diaconuccalin/CanSat2016/Documente/New folder (3)/cansat 3.jpg

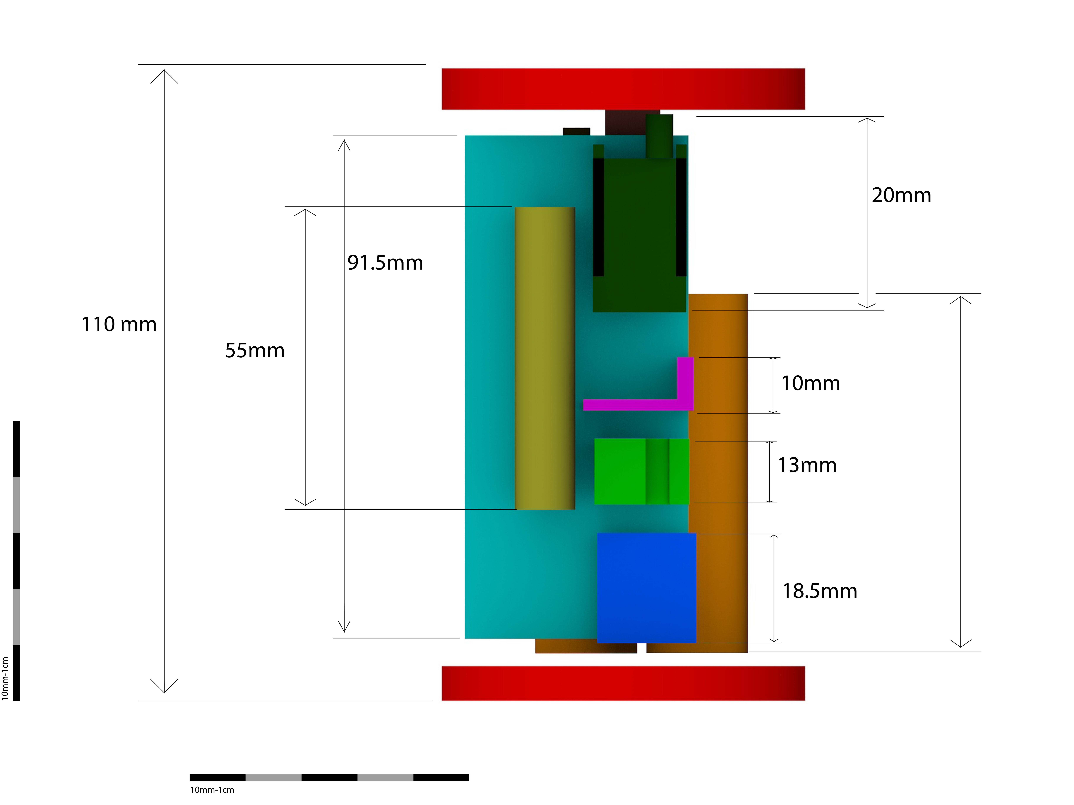
Documente/New folder (3)/cansat 3.jpg
