diaconuccalin/CanSat2016/Documente/qbcan_schematic.PNG

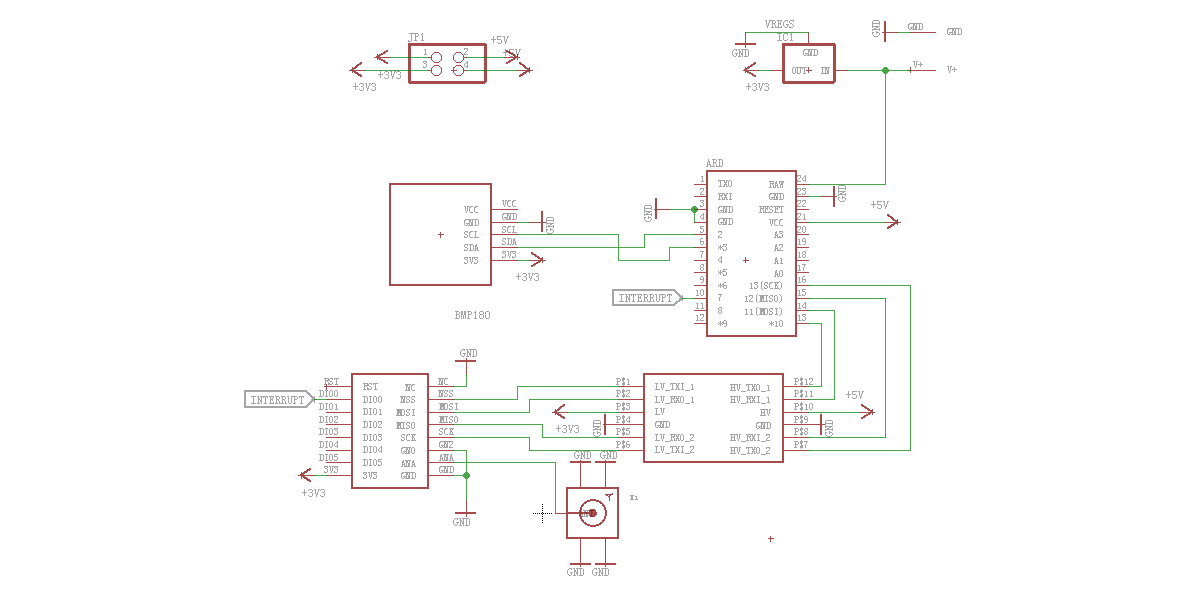
Documente/qbcan_schematic.PNG
