diaconuccalin/CanSat2016/Documente/schematic-dht11t.png

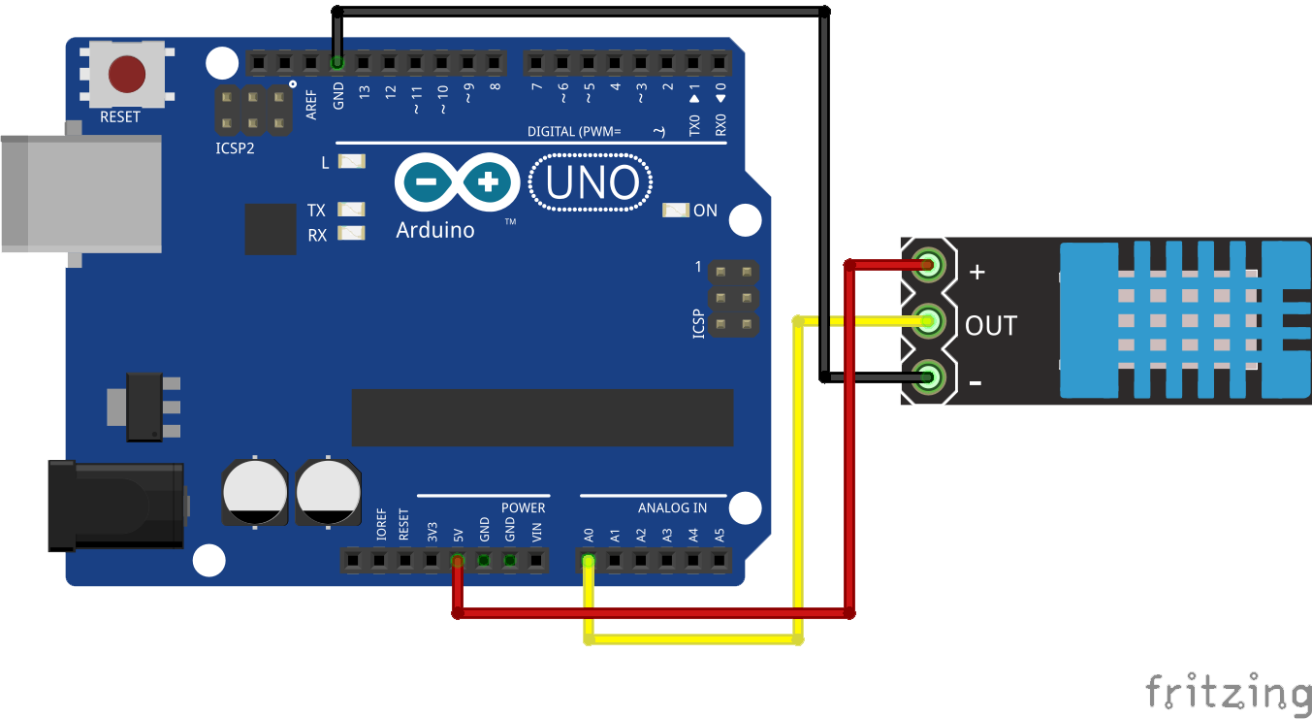
Documente/schematic-dht11t.png
