diaconuccalin/CanSat2016/(list of files, drawings)

Other design files:
Documente/fritzing/cansat.fzz
