diaconuccalin/CanSat2016/sketches/final_micro/final_micro.ino

//radio
#include <RFM69.h>

//sd
#include <SD.h>

//tempres
#include <qbcan.h>
#include <SPI.h>
#include <Wire.h>
BMP180 bmp;

<<<<<<< HEAD
=======
/*/accel
int SENSOR_SIGN[9] = {1,1,1,-1,-1,-1,1,1,1};
unsigned long previousMillisAcc = 0;

#include <L3G.h>
#include <LSM303.h>

L3G gyro;
LSM303 compass;

#define ToRad(x) ((x)*0.01745329252)
#define ToDeg(x) ((x)*57.2957795131)
#define Gyro_Scaled_X(x) ((x)*ToRad(0.07))
#define Gyro_Scaled_Y(x) ((x)*ToRad(0.07))
#define Gyro_Scaled_Z(x) ((x)*ToRad(0.07))

float G_Dt=0.02;
unsigned long timer=0, timer_old, timer24=0;
int AN[6], AN_OFFSET[6]={0,0,0,0,0,0};

int gyro_x, gyro_y, gyro_z, accel_x, accel_y, accel_z, magnetom_x, magnetom_y, magnetom_z;
float c_magnetom_x, c_magnetom_y, c_magnetom_z, MAG_Heading;
float Accel_Vector[3] = {0, 0, 0};
float Gyro_Vector[3] = {0, 0, 0};
float Omega_Vector[3] = {0, 0, 0};
float Omega_P[3] = {0, 0, 0};
float Omega_I[3] = {0, 0, 0};
float Omega[3] = {0, 0, 0};

float roll, pitch, yaw;
float errorRollPitch[3] = {0, 0, 0};
float errorYaw[3] = {0, 0, 0};

unsigned int counter=0;
byte gyro_sat=0;

float DCM_Matrix[3][3]= {
  {1,0,0},
  {0,1,0},
  {0,0,1}
}; 
float Update_Matrix[3][3]={{0,1,2},{3,4,5},{6,7,8}};

float Temporary_Matrix[3][3]={
  {
    0,0,0  }
  ,{
    0,0,0  }
  ,{
    0,0,0  }
};
*/
//temp+humid
unsigned long previousMillis = 0;
#include <dht.h>
#define dht_apin A0
dht DHT;

//GPS
#include <SoftwareSerial.h>
SoftwareSerial gpsSerial(9, 7); // RX, TX (TX not used)
char sentence[80];


>>>>>>> 387320f574f8ba8f5f3e8b936d95b204bb287ada
void setup()
{  
  //temp+pres
  bmp.begin();
<<<<<<< HEAD
=======
  
  /*/accelerometru
  Wire.begin();
  delay(1500);
  Accel_Init();
  Compass_Init();
  Gyro_Init();
  
  delay(20);

  for(int i=0; i<32; i++)
  {
    Read_Gyro();
    Read_Accel();
    for(int y=0; y<6; y++)
      AN_OFFSET[y]+=AN[y];
    delay(20);
  }

  for(int y=0; y<6; y++)
    AN_OFFSET[y] = AN_OFFSET[y]/32;

  AN_OFFSET[5]-=256*SENSOR_SIGN[5];

  delay(2000);

  timer=millis();
  delay(20);
  counter=0;
  */
  /*
  //speaker
  pinMode(6, OUTPUT);
  */
  //GPS
  Serial.begin(9600);
  gpsSerial.begin(9600);

  //SD
  while(!Serial)
  {;}

  Serial.println("Initializing SD card...");

  if(!SD.begin(8))
  {
    Serial.println("Card failed, or not present");
    return;
  }
  Serial.println("card initialized");
>>>>>>> 387320f574f8ba8f5f3e8b936d95b204bb287ada
}

void loop()
{
<<<<<<< HEAD
    //temp+pres
    double T, P;
    bmp.getData(T, P);

    Serial.print("Pressure: ");
    Serial.print(P, 2);
    Serial.println(" mb.");
    Serial.print("Temperature: ");
    Serial.print(T, 2);
    Serial.println(" deg C");
    //temp+pres   
=======
  //SD
  File dataFile = SD.open("data.txt", FILE_WRITE);
  if(dataFile)
  {
  //SD
  
  /*/----------------------------accelerometru----------------------------
  unsigned long currentMillisAcc = millis();
  //----------------------------accelerometru----------------------------
  */
  //temp+humid
  unsigned long currentMillis = millis();

  //------------------------------GPS------------------------------
  int a, flag=0;
  static int i = 0;
  if (gpsSerial.available())
  {
    char ch = gpsSerial.read();
    if (ch != '\n' && i < 80)
    {
      sentence[i] = ch;
      i++;
    }
    else
    {
     sentence[i] = '\0';
     i = 0;
     
     if(sentence[4]=='G')
     {
      dataFile.print("---------------GPS---------------\n");
      
      dataFile.print("GMT: ");
      dataFile.print(sentence[7]);
      dataFile.print(sentence[8]);
      dataFile.print(":");
      dataFile.print(sentence[9]);
      dataFile.print(sentence[10]);
      dataFile.print(":");
      dataFile.print(sentence[11]);
      dataFile.print(sentence[12]);
      dataFile.print("\n");
      
      dataFile.print("Lat: ");
      
      for(a=18; a<=26; a++)
        dataFile.print(sentence[a]);
      
      dataFile.print(" ");
      dataFile.print(sentence[28]);
      dataFile.print("\n");
      
      dataFile.print("Long: ");

      for(a=30; a<=39; a++)
        dataFile.print(sentence[a]);
      
      dataFile.print(" ");
      dataFile.print(sentence[41]);
      dataFile.print("\n");

      dataFile.print("Sat: ");
      dataFile.print(sentence[45]);
      dataFile.print(sentence[46]);
      dataFile.print("\n");

      dataFile.print("Alt: ");

      for(a=48; a<=60 && flag!=2; a++)
      {
        if(flag==0)
        {
          if(sentence[a]==',')
            flag=1;
        }
        else
        {
          if(flag==1)
          {
            if(sentence[a]==',')
              flag=2;
            else
              dataFile.print(sentence[a]);
          }
        }
      }
      dataFile.print(" m \n");
     }
    }
  }
  //------------------------------GPS------------------------------
  else
  {
    /*/acceleometru
    if((millis()-timer)>=20)
    {
      counter++;
      timer_old=timer;
      timer=millis();
      if(timer>timer_old)
        G_Dt = (timer-timer_old)/1000.0;
      else
        G_Dt = 0;

      Read_Gyro();
      Read_Accel();

      if(counter>5)
      {
        counter=0;
        Read_Compass();
        Compass_Heading();
      }

      Matrix_update();
      Normalize();
      Drift_correction();
      Euler_angles();
      if(currentMillisAcc-previousMillisAcc>=20)
      {
        previousMillisAcc=currentMillisAcc;
        dataFile.close();
        printdata();
        dataFile = SD.open("data.txt", FILE_WRITE);
      }
    }
    //accelerometru
    */
    //temp+humid
    if(currentMillis-previousMillis>=2000) //minim 2 secunde intre citiri
    {
      previousMillis=currentMillis;
      DHT.read11(dht_apin);
      
      dataFile.print("\nhum=");
      dataFile.print(DHT.humidity);
      dataFile.print("% temp=");
      dataFile.print(DHT.temperature);
      dataFile.print("C \n");
    }
    //temp+humid

    //temp+pres
    double T, P;
    bmp.getData(T,P);
    
    dataFile.print("Pressure: ");
    dataFile.print(P, 2);
    dataFile.println(" mb.");
    dataFile.print("Temperature: ");
    dataFile.print(T,2);
    dataFile.println(" deg C.");
    //temp+pres
 }

/*  //speaker
  digitalWrite(6, HIGH);
  delay(1);
  digitalWrite(6,LOW);
  //speaker
*/
  //SD
  dataFile.close();
  }
  else
  {
    Serial.println("error opening data.txt :(");
  }
  //SD
}



/*


//---------------------------------accelerometru---------------------------------
void Gyro_Init()
{
  gyro.init();
  gyro.enableDefault();
  gyro.writeReg(L3G::CTRL_REG4, 0x20);
  gyro.writeReg(L3G::CTRL_REG1, 0x0F);
}

void Read_Gyro()
{
  gyro.read();
  
  AN[0] = gyro.g.x;
  AN[1] = gyro.g.y;
  AN[2] = gyro.g.z;
  gyro_x = SENSOR_SIGN[0] * (AN[0] - AN_OFFSET[0]);
  gyro_y = SENSOR_SIGN[1] * (AN[1] - AN_OFFSET[1]);
  gyro_z = SENSOR_SIGN[2] * (AN[2] - AN_OFFSET[2]);
}

void Accel_Init()
{
  compass.init();
  compass.enableDefault();
  switch(compass.getDeviceType())
  {
    case LSM303::device_D:
      compass.writeReg(LSM303::CTRL2, 0x18);
      break;
    case LSM303::device_DLHC:
      compass.writeReg(LSM303::CTRL_REG4_A, 0x28);
      break;
    default:
      compass.writeReg(LSM303::CTRL_REG4_A, 0x30);
  }
}

void Read_Accel()
{
  compass.readAcc();

  AN[3] = compass.a.x >> 4;
  AN[4] = compass.a.y >> 4;
  AN[5] = compass.a.z >> 4;
  accel_x = SENSOR_SIGN[3] * (AN[3] - AN_OFFSET[3]);
  accel_y = SENSOR_SIGN[4] * (AN[4] - AN_OFFSET[4]);
  accel_z = SENSOR_SIGN[5] * (AN[5] - AN_OFFSET[5]);
}

void Compass_Init(){}

void Read_Compass()
{
  compass.readMag();

  magnetom_x = SENSOR_SIGN[6] * compass.m.x;
  magnetom_y = SENSOR_SIGN[7] * compass.m.y;
  magnetom_z = SENSOR_SIGN[8] * compass.m.z;
}

void Compass_Heading()
{
  float MAG_X;
  float MAG_Y;
  float cos_roll;
  float sin_roll;
  float cos_pitch;
  float sin_pitch;
  
  cos_roll = cos(roll);
  sin_roll = sin(roll);
  cos_pitch = cos(pitch);
  sin_pitch = sin(pitch);
  
  c_magnetom_x = (float)(magnetom_x - SENSOR_SIGN[6]*(-421)) / (424 - (-421)) - SENSOR_SIGN[6]*0.5;
  c_magnetom_y = (float)(magnetom_y - SENSOR_SIGN[7]*(-639)) / (295 - (-639)) - SENSOR_SIGN[7]*0.5;
  c_magnetom_z = (float)(magnetom_z - SENSOR_SIGN[8]*(-238)) / (472 - (-238)) - SENSOR_SIGN[8]*0.5;
  
  MAG_X = c_magnetom_x*cos_pitch+c_magnetom_y*sin_roll*sin_pitch+c_magnetom_z*cos_roll*sin_pitch;
  MAG_Y = c_magnetom_y*cos_roll-c_magnetom_z*sin_roll;
  MAG_Heading = atan2(-MAG_Y,MAG_X);
}

void Matrix_update(void)
{
  Gyro_Vector[0]=Gyro_Scaled_X(gyro_x);
  Gyro_Vector[1]=Gyro_Scaled_Y(gyro_y);
  Gyro_Vector[2]=Gyro_Scaled_Z(gyro_z);

  Accel_Vector[0]=accel_x;
  Accel_Vector[1]=accel_y;
  Accel_Vector[2]=accel_z;

  Vector_Add(&Omega[0], &Gyro_Vector[0], &Omega_I[0]);
  Vector_Add(&Omega_Vector[0], &Omega[0], &Omega_P[0]);
       
  Update_Matrix[0][0]=0;
  Update_Matrix[0][1]=-G_Dt*Omega_Vector[2];
  Update_Matrix[0][2]=G_Dt*Omega_Vector[1];
  Update_Matrix[1][0]=G_Dt*Omega_Vector[2];
  Update_Matrix[1][1]=0;
  Update_Matrix[1][2]=-G_Dt*Omega_Vector[0];
  Update_Matrix[2][0]=-G_Dt*Omega_Vector[1];
  Update_Matrix[2][1]=G_Dt*Omega_Vector[0];
  Update_Matrix[2][2]=0;
  
  Matrix_Multiply(DCM_Matrix,Update_Matrix,Temporary_Matrix);

  for(int x=0; x<3; x++)
  {
    for(int y=0; y<3; y++)
    {
      DCM_Matrix[x][y]+=Temporary_Matrix[x][y];
    } 
  }
}

void Normalize(void)
{
  float error=0;
  float temporary[3][3];
  float renorm=0;
  
  error= -Vector_Dot_Product(&DCM_Matrix[0][0],&DCM_Matrix[1][0])*.5;

  Vector_Scale(&temporary[0][0], &DCM_Matrix[1][0], error);
  Vector_Scale(&temporary[1][0], &DCM_Matrix[0][0], error);
  
  Vector_Add(&temporary[0][0], &temporary[0][0], &DCM_Matrix[0][0]);
  Vector_Add(&temporary[1][0], &temporary[1][0], &DCM_Matrix[1][0]);
  
  Vector_Cross_Product(&temporary[2][0],&temporary[0][0],&temporary[1][0]);
  
  renorm= .5 *(3 - Vector_Dot_Product(&temporary[0][0],&temporary[0][0]));
  Vector_Scale(&DCM_Matrix[0][0], &temporary[0][0], renorm);
  
  renorm= .5 *(3 - Vector_Dot_Product(&temporary[1][0],&temporary[1][0]));
  Vector_Scale(&DCM_Matrix[1][0], &temporary[1][0], renorm);
  
  renorm= .5 *(3 - Vector_Dot_Product(&temporary[2][0],&temporary[2][0]));
  Vector_Scale(&DCM_Matrix[2][0], &temporary[2][0], renorm);
}

void Drift_correction(void)
{
  float mag_heading_x;
  float mag_heading_y;
  float errorCourse;
  //Compensation the Roll, Pitch and Yaw drift. 
  static float Scaled_Omega_P[3];
  static float Scaled_Omega_I[3];
  float Accel_magnitude;
  float Accel_weight;
  
  Accel_magnitude = sqrt(Accel_Vector[0]*Accel_Vector[0] + Accel_Vector[1]*Accel_Vector[1] + Accel_Vector[2]*Accel_Vector[2]);
  Accel_magnitude = Accel_magnitude / 256;
  
  Accel_weight = constrain(1 - 2*abs(1 - Accel_magnitude),0,1); 

  Vector_Cross_Product(&errorRollPitch[0],&Accel_Vector[0],&DCM_Matrix[2][0]);
  Vector_Scale(&Omega_P[0],&errorRollPitch[0],0.02*Accel_weight);
  
  Vector_Scale(&Scaled_Omega_I[0],&errorRollPitch[0],0.00002*Accel_weight);
  Vector_Add(Omega_I,Omega_I,Scaled_Omega_I);     
  
  mag_heading_x = cos(MAG_Heading);
  mag_heading_y = sin(MAG_Heading);
  errorCourse=(DCM_Matrix[0][0]*mag_heading_y) - (DCM_Matrix[1][0]*mag_heading_x);
  Vector_Scale(errorYaw,&DCM_Matrix[2][0],errorCourse); 
  
  Vector_Scale(&Scaled_Omega_P[0],&errorYaw[0],1.2);
  Vector_Add(Omega_P,Omega_P,Scaled_Omega_P);
  
  Vector_Scale(&Scaled_Omega_I[0],&errorYaw[0],0.00002);
  Vector_Add(Omega_I,Omega_I,Scaled_Omega_I);
}

void Euler_angles(void)
{
  pitch = -asin(DCM_Matrix[2][0]);
  roll = atan2(DCM_Matrix[2][1],DCM_Matrix[2][2]);
  yaw = atan2(DCM_Matrix[1][0],DCM_Matrix[0][0]);
}

void printdata(void)
{    
      File dataFile = SD.open("data.txt", FILE_WRITE);
      dataFile.print("!");

      dataFile.print("ANG:");
      dataFile.print(ToDeg(roll));
      dataFile.print(",");
      dataFile.print(ToDeg(pitch));
      dataFile.print(",");
      dataFile.print(ToDeg(yaw));
     
      dataFile.println();

      dataFile.close();
}

float Vector_Dot_Product(float vector1[3],float vector2[3])
{
  float op=0;
  
  for(int c=0; c<3; c++)
  {
  op+=vector1[c]*vector2[c];
  }
  
  return op; 
}

void Vector_Cross_Product(float vectorOut[3], float v1[3],float v2[3])
{
  vectorOut[0]= (v1[1]*v2[2]) - (v1[2]*v2[1]);
  vectorOut[1]= (v1[2]*v2[0]) - (v1[0]*v2[2]);
  vectorOut[2]= (v1[0]*v2[1]) - (v1[1]*v2[0]);
}

void Vector_Scale(float vectorOut[3],float vectorIn[3], float scale2)
{
  for(int c=0; c<3; c++)
  {
   vectorOut[c]=vectorIn[c]*scale2; 
  }
}

void Vector_Add(float vectorOut[3],float vectorIn1[3], float vectorIn2[3])
{
  for(int c=0; c<3; c++)
  {
     vectorOut[c]=vectorIn1[c]+vectorIn2[c];
  }
}

void Matrix_Multiply(float a[3][3], float b[3][3],float mat[3][3])
{
  float op[3]; 
  for(int x=0; x<3; x++)
  {
    for(int y=0; y<3; y++)
    {
      for(int w=0; w<3; w++)
      {
       op[w]=a[x][w]*b[w][y];
      } 
      mat[x][y]=0;
      mat[x][y]=op[0]+op[1]+op[2];
      
      float test=mat[x][y];
    }
  }
>>>>>>> 387320f574f8ba8f5f3e8b936d95b204bb287ada
}
//---------------------------------accelerometru---------------------------------
*/
