diaconuccalin/CanSat2016/sketches/dht111/dht111.ino

#include <dht.h>
#define dht_apin A0

dht DHT;
 
void setup()
{
  Serial.begin(9600);
  delay(500);//Delay to let system boot
  Serial.println("DHT11 Humidity & temperature Sensor\n\n");
  delay(1000);//Wait before accessing Sensor
}

void loop()
{
    DHT.read11(dht_apin);
    
    Serial.print("Current humidity = ");
    Serial.print(DHT.humidity);
    Serial.print("%  ");
    Serial.print("temperature = ");
    Serial.print(DHT.temperature); 
    Serial.println("C  "); 
    delay(2000);//minim 2 secunde
}
