diaconuccalin/CanSat2016/(commit log)

2016-03-03 Sketch-uri
    Am eliminat sketch-urile inutile. Au ramas sketch-urile pt fiecare
    senzor si toate combinate. Codul final functioneaza deocamdata doar pe
    arduino uno
2016-03-04 Am pus toate documentele de azi intr-un folder
2016-03-21 reducere spatiu
    Am sters toate serial print-urile ca sa mai reduc dimensiunile
2016-03-21 sters
    am mai sters cate ceva. la dimensiuni nu s-a schimbat nimic
2016-03-21 fara accelerometru
    Am pus codul de la accelerometru in comentariu si a scazut pana la 80%
    (de la 113%) din capacitatea memoriei
2016-04-10 sketch aproape final
    mai trebuie adaugata optiunea de control a motoarelor
